theFork/midiSwitcher/hardware/mainbrd2/bom.txt

Atmega128RFA:

1x 0.25
Balun 100Ohm balanced, 50Ohm unbalanced
http://de.mouser.com/ProductDetail/Murata/LDB212G4010C-001/?qs=sGAEpiMZZMtMMXztyU6kdNOHRalcvD6j579H8Ei3rTA%3d

1x 1.26
Chipantenne
http://de.mouser.com/ProductDetail/Linx-Technologies/ANT-245-CHP-T/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
