theFork/midiSwitcher/hardware/mainbrd2/doc/spec.tex

\section{4x4 3.3V GPIO ports}
\section{$2.4~GHz$ wireless interface}
\section{$I^2C$ interface}
\section{Voltage supply}
$7~..~12~V$ input
$3.3~V$ internal voltage supply

\section{}
\section{}
\section{}
\section{}
