theFork/midiSwitcher/hardware/doku/portBelegung.pdf

Tabelle1

IC-PIN | Port / Bezeichnung | Nr. | Funktion
1
2 | PORT D (USART) | | RXD
3 | | | TXD
4 | Port D | 2 | FX-0
5 | | 3 | FX-1
6 | | 4 | FX-2
7
8
9
10
11 | Port D | 5 | FX-3
12 | | 6 | FX-4
13 | | 7 | FX-5
14 | Port B | 0 | FX-6
15 | | 1 | FX-7
16 | | 2 | LED A (Edit)
17 | | 3 | Taster B-1
18 | | 4 | Taster B-2
19 | | 5 | Taster B-3
20
21
22
23 | PORT C | 0 | Taster B-4
24 | | 1 | Taster A-1
25 | | 2 | Taster A-2
26 | | 3 | Taster A-3
27 | | 4 | Taster A-4
28 | | 5 | Taster A-5
