theFork/midiSwitcher/hardware/control_dog/maske.TIF

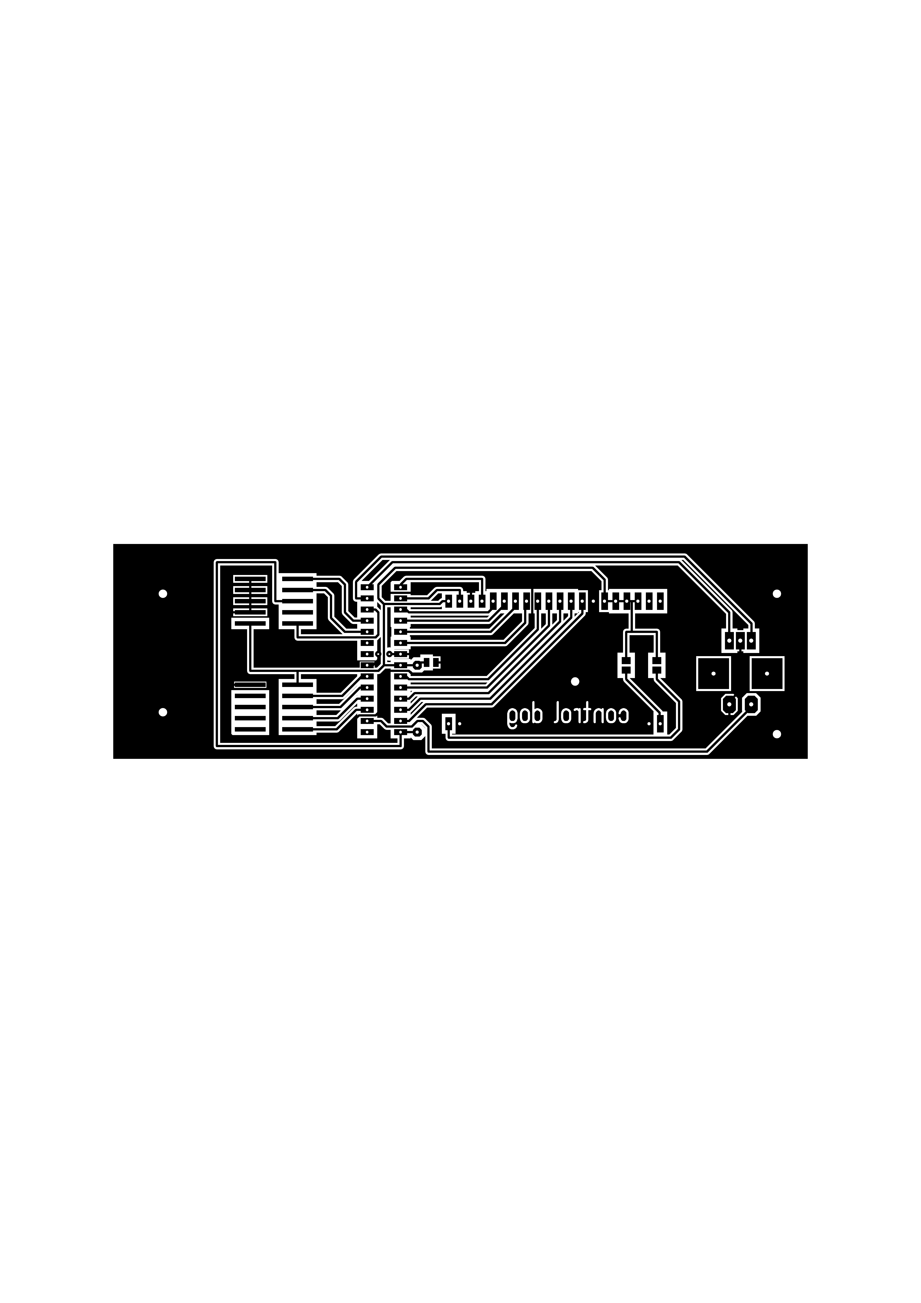
hardware/control_dog/maske.TIF
