theFork/midiSwitcher/hardware/control_dog/maske_2Fach.png

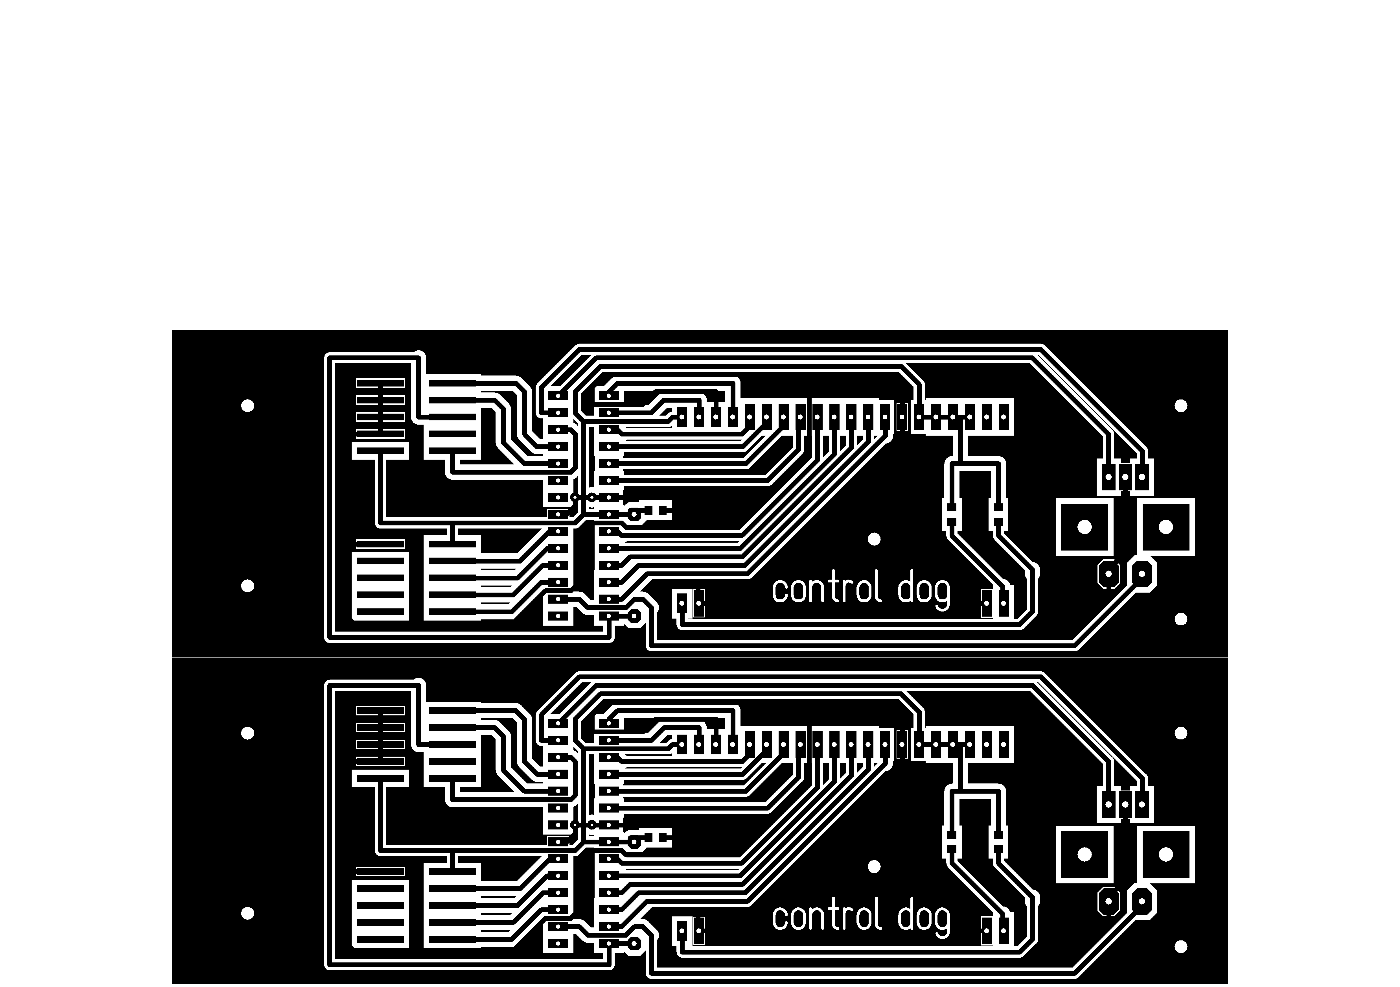
hardware/control_dog/maske_2Fach.png
