theFork/midiSwitcher/hardware/masken/ctrlDog.png

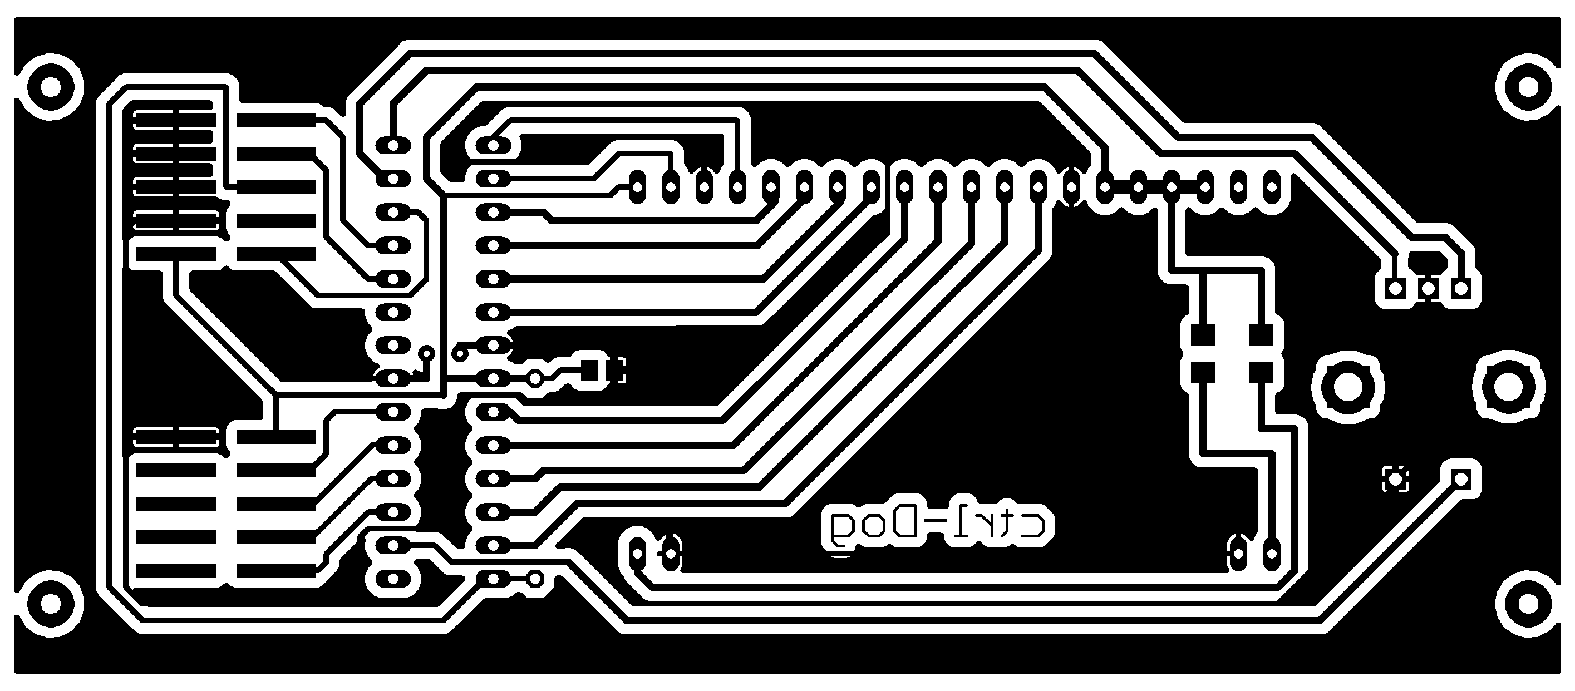
hardware/masken/ctrlDog.png
