theFork/midiSwitcher/hardware/masken/dualLoop.png

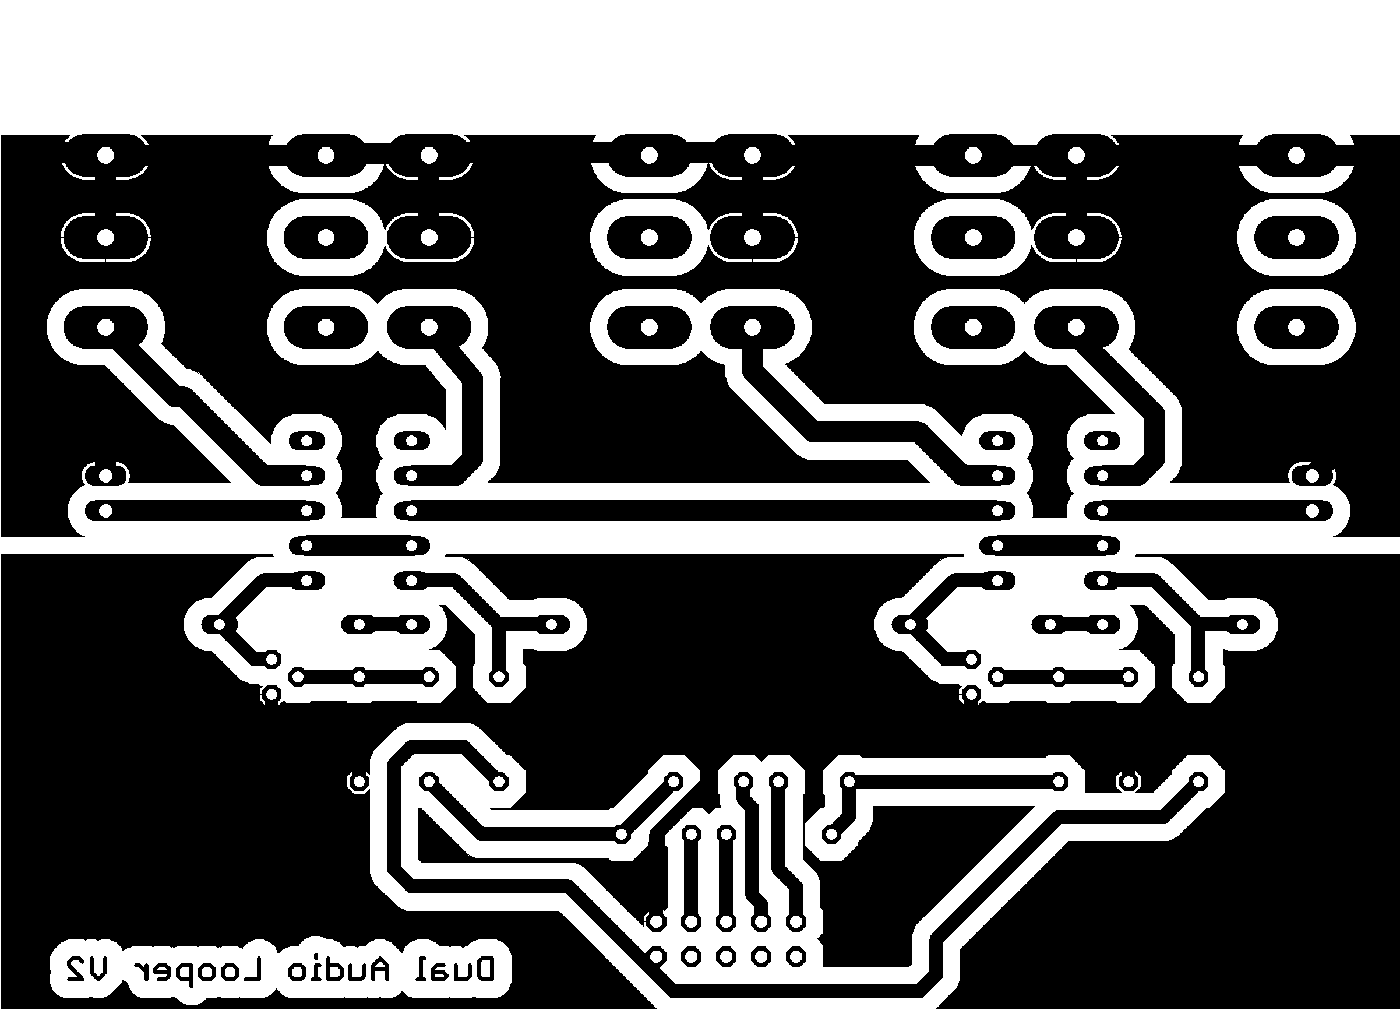
hardware/masken/dualLoop.png
