theFork/midiSwitcher/hardware/masken/dualSwitch.png

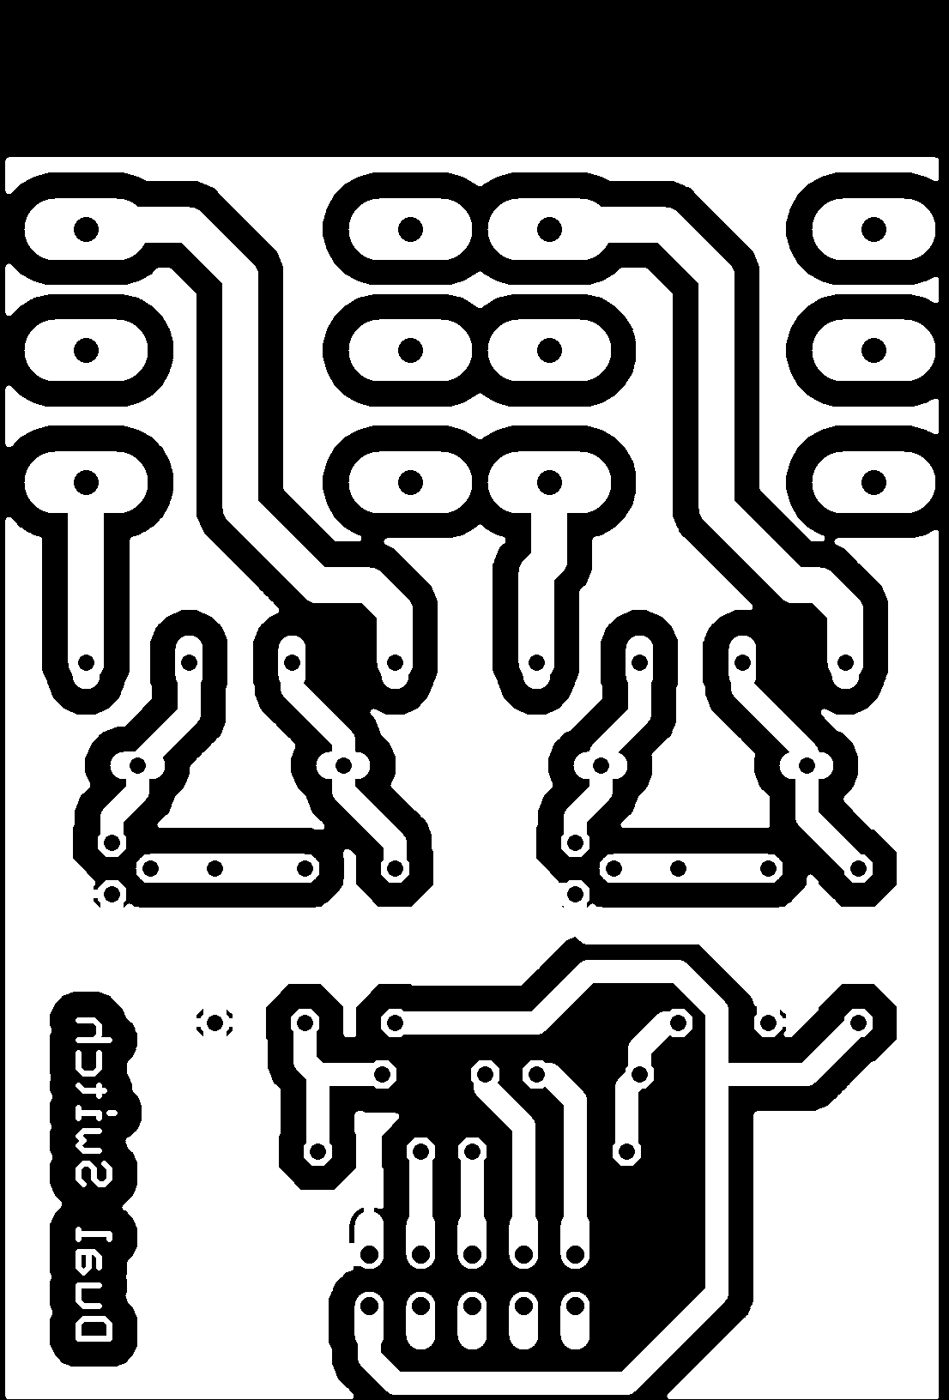
hardware/masken/dualSwitch.png
