theFork/midiSwitcher/hardware/masken/mainbrd.png

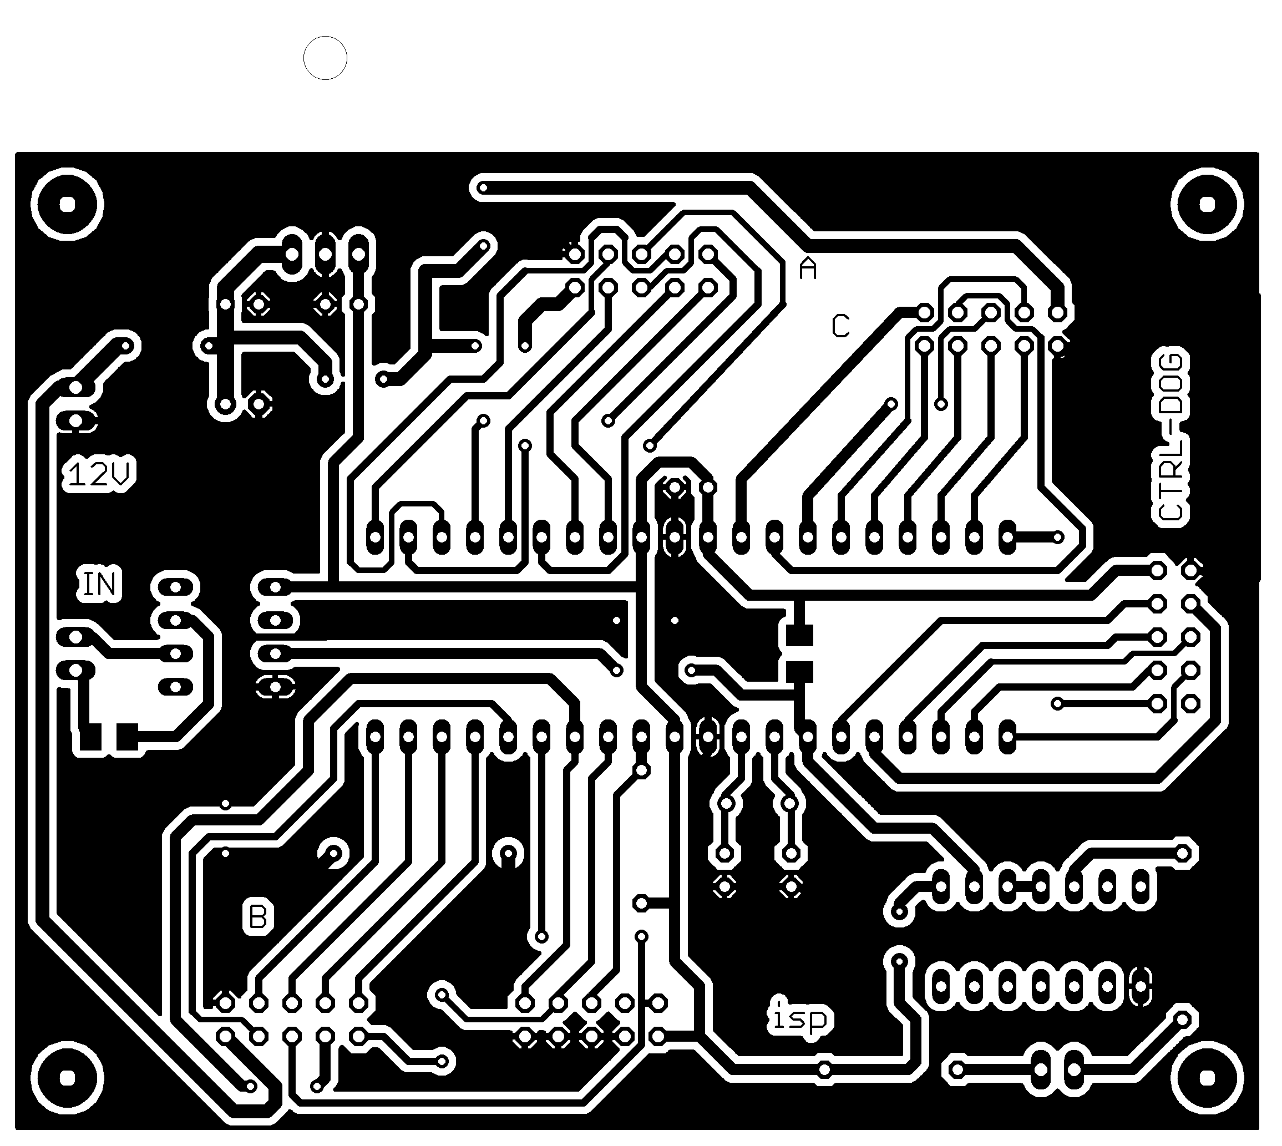
hardware/masken/mainbrd.png
