theFork/midiSwitcher/hardware/masken/netzteil.png

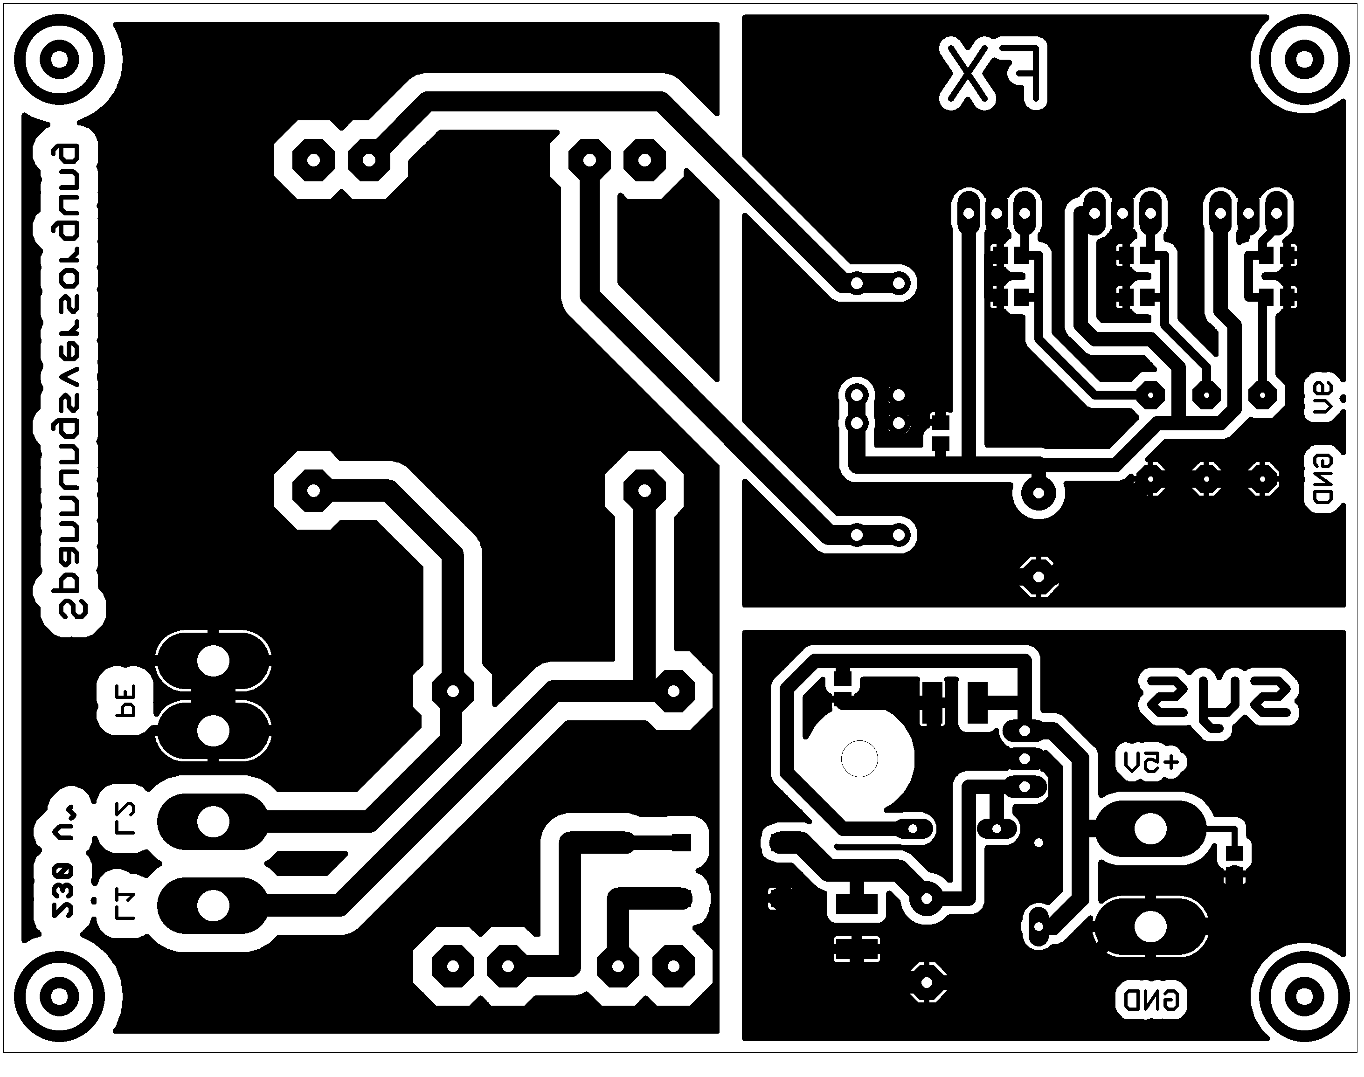
hardware/masken/netzteil.png
