theFork/midiSwitcher/hardware/masken/programmer3x.png

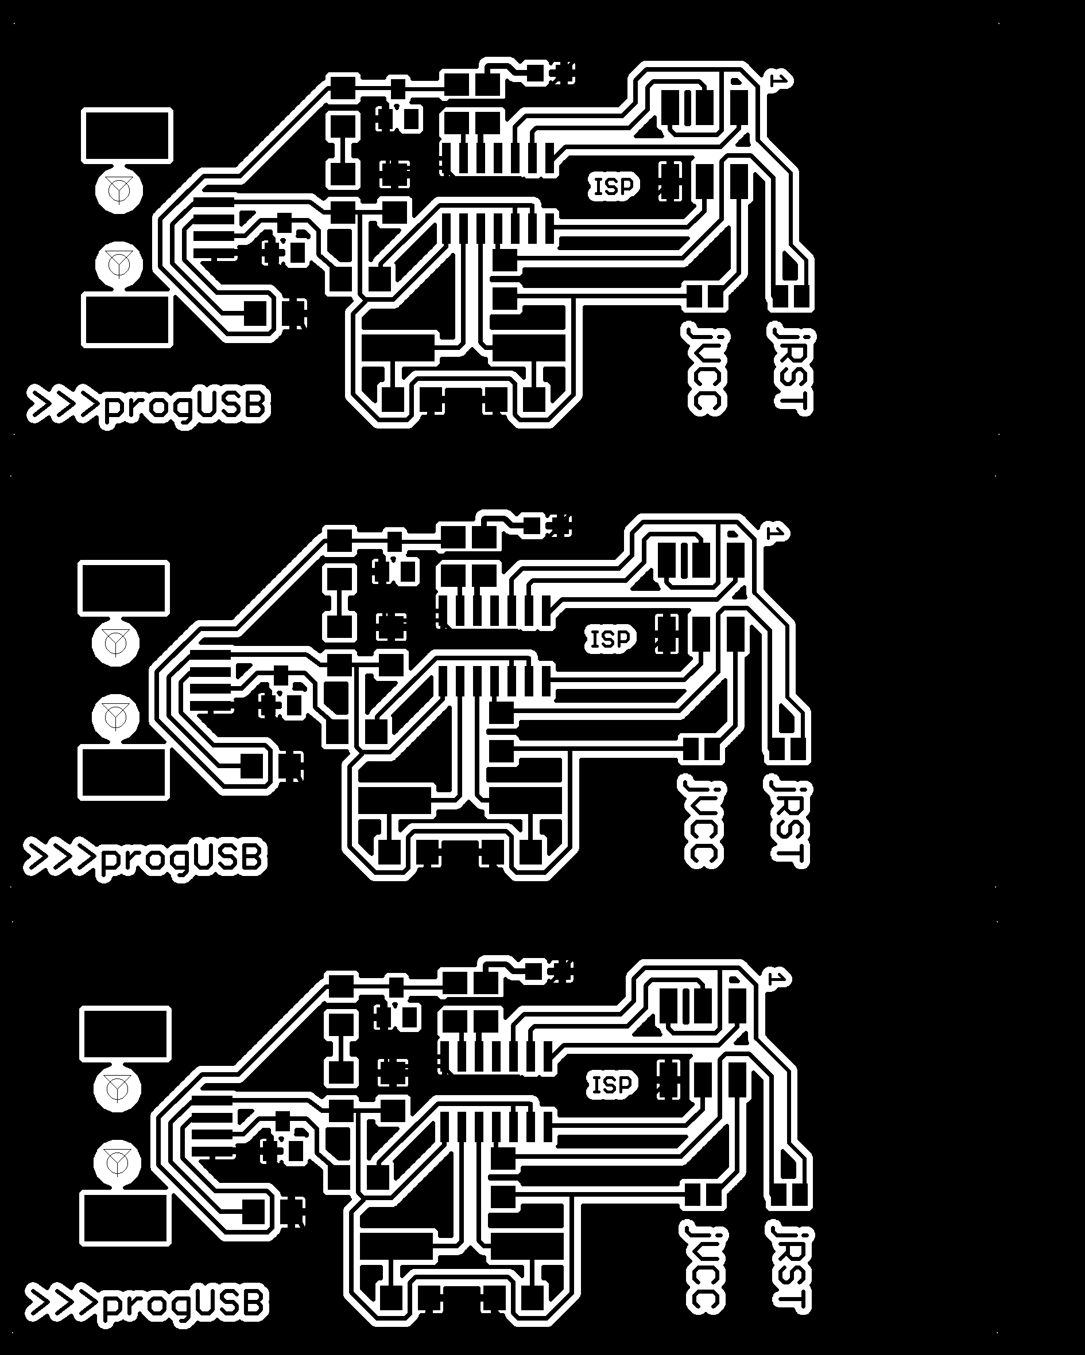
hardware/masken/programmer3x.png
