theFork/midiSwitcher/hardware/masken/programmer.png

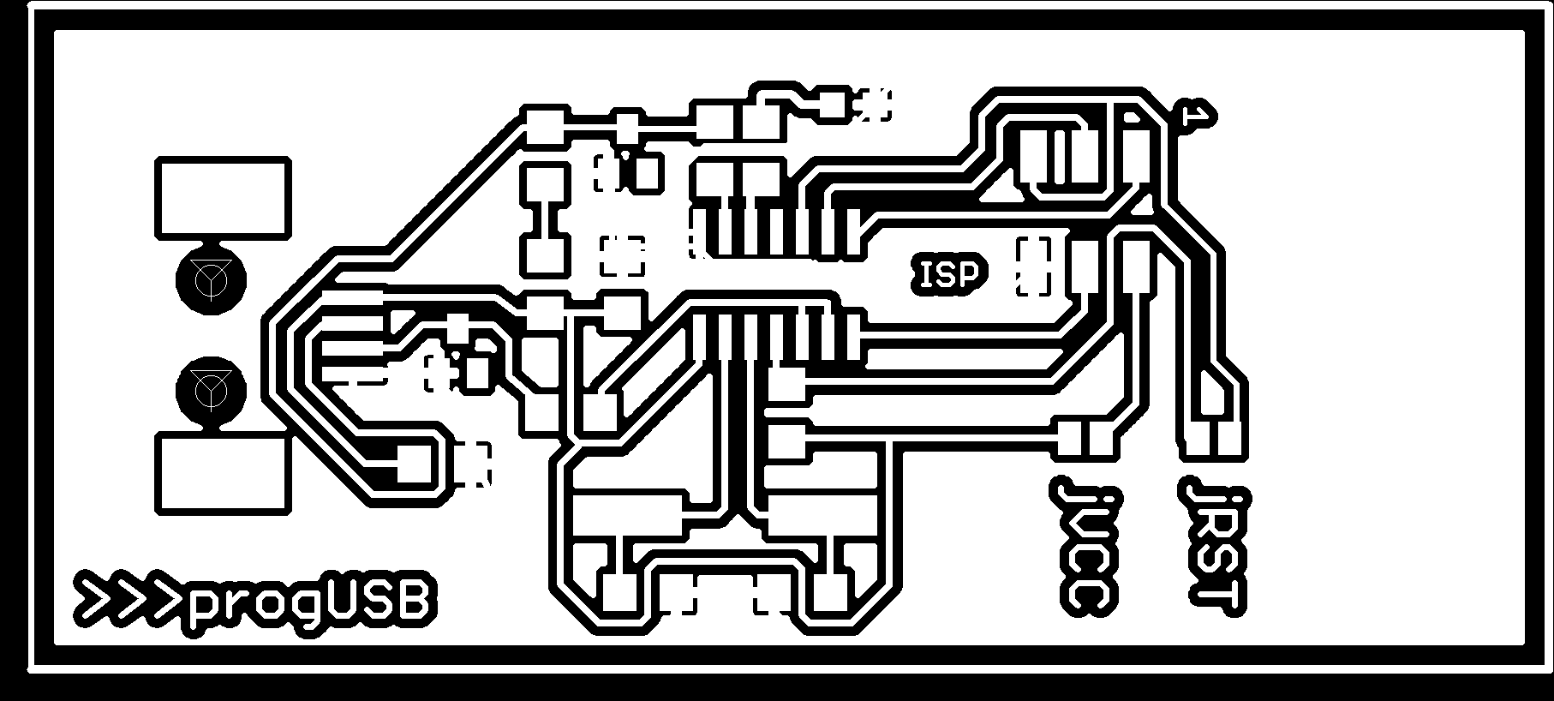
hardware/masken/programmer.png
