theFork/midiSwitcher/hardware/aktoren/DualLoopV2/bauteilliste.ods

Bauteilliste 4er Relaisplatine
Anzahl | Reichelt Art.Nr. | Stückpreis | Gesamt | Kommentar
4 | EBS 63P | 0,28 € | 1,12 € | Stereo-Klinkenbuchse mit Schalter
4 | G6H-2 6V | 2,70 € | 10,80 € | Relais
4 | 1N 4148 | 0,02 € | 0,08 € | Diode
4 | BC 547B | 0,04 € | 0,16 € | Transistor BC547B
8 | 1/4W 2,2K | 0,03 € | 0,26 € | Widerstand 2K2 10STK BESTELLEN!
4 | 1/4W 220 | 0,03 € | 0,13 € | Widerstand 220 10STK BESTELLEN!
 |  |  | 0,00 €
 |  |  | 0,00 €
 |  |  | 0,00 €
 |  | Summe: | 12,56 €
