theFork/midiSwitcher/hardware/bauteile.ods

Mainboard: |  |  |  | Modul "Dual Looper":
1x | BEL 75x100-1 | 0,96 € | 0,96 € | 1x | BEL 75X100-1 | 0,96 € | 0,96 €
3x | MKS-02 100N | 0,14 € | 0,42 € | 2x | T 9146 GN | 2,50 € | 5,00 €
1x | RAD 100/16 | 0,04 € | 0,04 € | 2x | 1/4W 1,0K | 0,10 € | 0,20 €
1x | ATMEGA 16-16 DIP | 3,65 € | 3,65 € | 2x | PFL 10 | 0,08 € | 0,16 €
1x | GS 40P | 0,55 € | 0,55 € | 4x | EBS 63P | 0,27 € | 1,08 €
5x | WSL 10G | 0,08 € | 0,40 € | 2x | G6H-2 6V | 2,95 € | 5,90 €
1x | 6N 138 | 0,58 € | 0,58 € | 2x | BC 547B | 0,04 € | 0,08 €
1x | µA 7805 | 0,28 € | 0,28 € | 2x | 1/4W 220 | 0,10 € | 0,20 €
1x | 74HC 14 | 0,22 € | 0,22 € | 4x | 1/4W 2,2K | 0,10 € | 0,40 €
1x | SMD 1/4W 220 | 0,10 € | 0,10 € | 1x | WSL 10G | 0,08 € | 0,08 €
1x | SMD 1/4W 1k | 0,10 € | 0,10 € | 2x | 1N 4148 | 0,02 € | 0,04 €
1x | 1/4W10k | 0,10 € | 0,10 € | 2x | ZF 30 | 0,04 € | 0,08 €
2x | 1/4W220 | 0,10 € | 0,20 € |  |  |  | 14,18 €
3x | PS 25/2G WS | 0,29 € | 0,87 €
4x | AHS 4,8 | 0,29 € | 1,16 € | Modul "Dual Switch":
2x | DIO-50S EMS | 1,85 € | 3,70 € | 1x | BEL 75X100-1 | 0,96 € | 0,96 €
1x | AWG 28-10F 3M | 2,90 € | 2,90 € | 2x | T 9146 GN | 2,50 € | 5,00 €
2x | PFL 10 | 0,08 € | 0,16 € | 2x | PFL 10 | 0,08 € | 0,16 €
2x | EBS 63P | 0,27 € | 0,54 € | 2x | EBS 63P | 0,27 € | 0,54 €
 |  |  | 16,23 € | 2x | SIL 7271-L 5V | 1,60 € | 3,20 €
 |  |  |  | 2x | BC 547B | 0,04 € | 0,08 €
 |  |  |  | 2x | 1/4W 470 | 0,10 € | 0,20 €
Spannungsversorgung: |  |  |  | 4x | 1/4W 2,2K | 0,10 € | 0,40 €
1x | BEL 160x100-1 | 1,70 € | 1,70 € | 1x | WSL 10G | 0,08 € | 0,08 €
1x | 421.15-1 | 3,20 € | 3,20 € | 2x | 1N 4148 | 0,02 € | 0,04 €
1x | EI 54/18,8 112 | 6,20 € | 6,20 € |  |  |  | 10,66 €
1x | SMD DF 02 | 0,21 € | 0,21 €
6x | 1N 4001 | 0,02 € | 0,12 € | Programmer
4x | X7R-G0805 100N | 0,05 € | 0,20 € | 1x | BEL 75x100-1 | 0,96 € | 0,96 €
2x | SMD-1812 330N | 0,52 € | 1,04 € | 2x | X7R-G1206 100N | 0,05 € | 0,10 €
2x | RAD FC 470/63 | 0,72 € | 1,44 € | 1x | X7R-G1206 10/25 | 0,24 € | 0,24 €
3x | µA 7809 | 0,32 € | 0,96 € | 2x | NPO-G1206 22P | 0,05 € | 0,10 €
1x | µA 7812 | 0,30 € | 0,30 € | 2x | SMD ZD 3,3 | 0,05 € | 0,10 €
5x | X7R-G0805 1,0/16 | 0,05 € | 0,25 € | 1x | ATTINY 44-20 SSU | 2,35 € | 2,35 €
1x | KES 3SI | 1,25 € | 1,25 € | 1x | SMD-LED 0805 GN | 0,09 € | 0,09 €
1x | FLINK 1,8A | 0,29 € | 0,29 € | 1x | 12,0000-HC49-SMD | 0,24 € | 0,24 €
5x | AHS 9,5 | 0,42 € | 2,10 € | 2x | SMD 1/4W 51 | 0,10 € | 0,20 €
 |  |  | 17,16 € | 2x | SMD 1/4W 510 | 0,10 € | 0,20 €
 |  |  |  | 1x | SMD 1/4W 1,0K | 0,10 € | 0,10 €
 |  |  |  | 1x | SMD 1/4W 10K | 0,10 € | 0,10 €
CTRL-DOG: |  |  |  | 1x | USB BW SMD | 0,62 € | 0,62 €
1x | BEL 75x100-1 | 0,96 € | 0,96 € | 1x | SL 2X10G SMD2,54 | 0,48 € | 0,48 €
1x | EADOGM162E-A | 11,85 € | 11,85 € |  |  |  | 5,88 €
1x | EA LED55X31-G | 3,15 € | 3,15 €
1x | KNOPF 13-164E | 0,39 € | 0,39 €
1x | STEC12E08 | 1,90 € | 1,90 €
1x | ATMEGA 8-16 DIP | 2,60 € | 2,60 €
1x | SL 2X10G SMD2,54 | 0,48 € | 0,48 €
1x | X7R-G0805 100N | 0,05 € | 0,05 €
1x | SMD 1/4W 10K | 0,10 € | 0,10 €
2x | SMD 1/4W 56 | 0,10 € | 0,20 €
4x | AHS 15,9 | 0,42 € | 1,68 €
 |  |  | 23,36 €
 |  |  |  | Beispiel (haggl):
 |  |  |  | 1x | Rackgehäuse | 45,00 € | 45,00 €
 |  |  |  | 1x | Stromversorgung | 17,16 € | 17,16 €
 |  |  |  | 1x | Mainboard | 16,23 € | 16,23 €
 |  |  |  | 2x | +-- DL | 14,18 € | 28,36 €
 |  |  |  | 2x | +-- DL | 14,18 € | 28,36 €
 |  |  |  | 2x | +-- DS | 10,66 € | 21,32 €
 |  |  |  | 1x | CTRL-DOG | 23,36 € | 23,36 €
 |  |  |  | 2x | Programmer | 5,88 € | 11,76 €
 |  |  |  |  |  |  | 179,79 €
