theFork/midiSwitcher/hardware/doku/rueckplatteV1.dxf

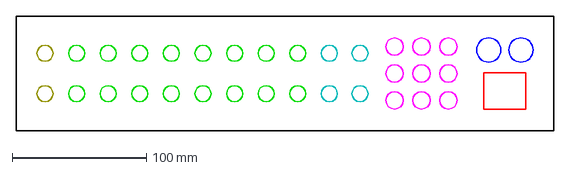
[picture p10: CAD file, 2013-02-09]
hardware/doku/rueckplatteV1.dxf
400.0 x 85.0 mm
