theFork/midiSwitcher/hardware/doku/frontplatteV1.dxf

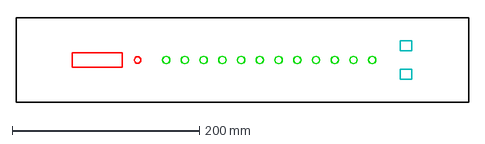
[picture p11: CAD file, 2013-02-09]
hardware/doku/frontplatteV1.dxf
483.0 x 90.0 mm
