theFork/midiSwitcher/hardware/aktoren/Quadmachine/specs/amphenol jack.pdf

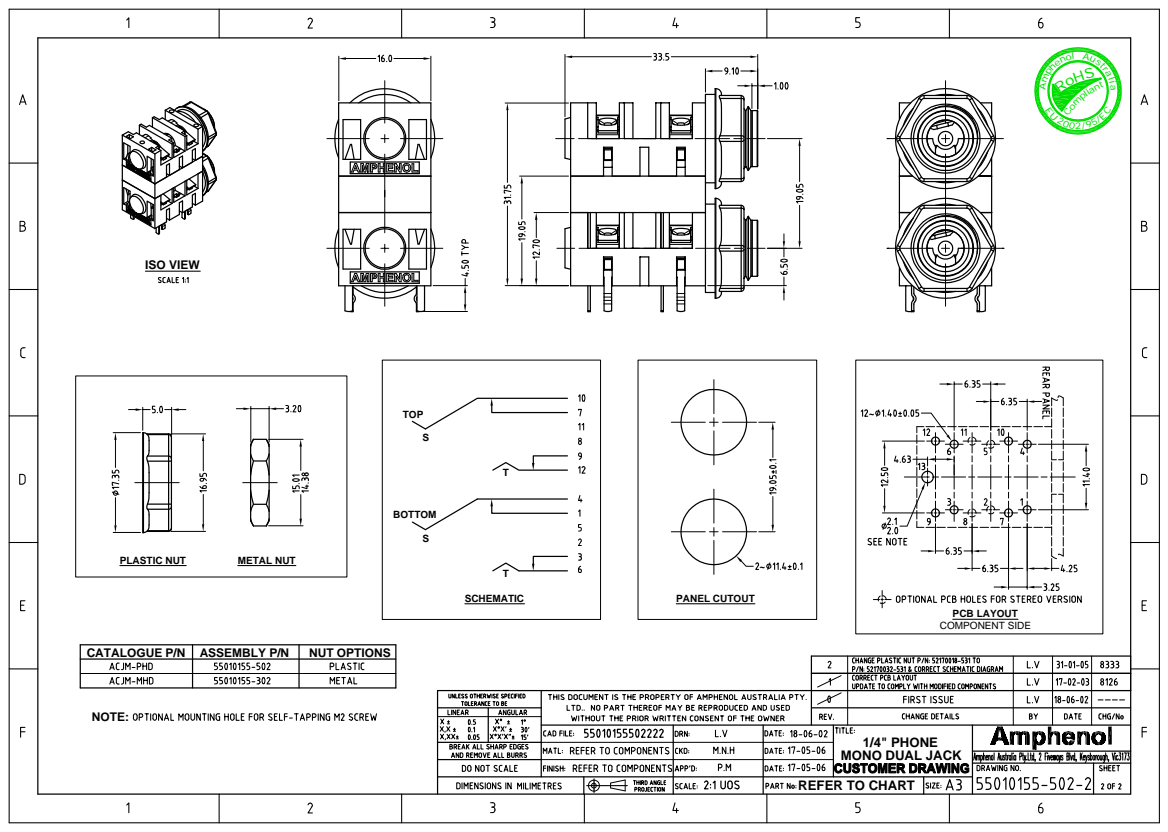
[picture p12: page 1]
ISO VIEW; PLASTIC NUT; METAL NUT; ial p m nt; l Au rts; SCHEMATIC; BOTTOM; TOP; PCB LAYOUT COMPONENT SIDE; PANEL CUTOUT; ASSEMBLY P/N; NOTE:; CATALOGUE P/N; NUT OPTIONS

1/4" PHONE MONO DUAL JACK

REFER TO CHART
