theFork/midiSwitcher/hardware/control_dog/ctrl_dog.pdf

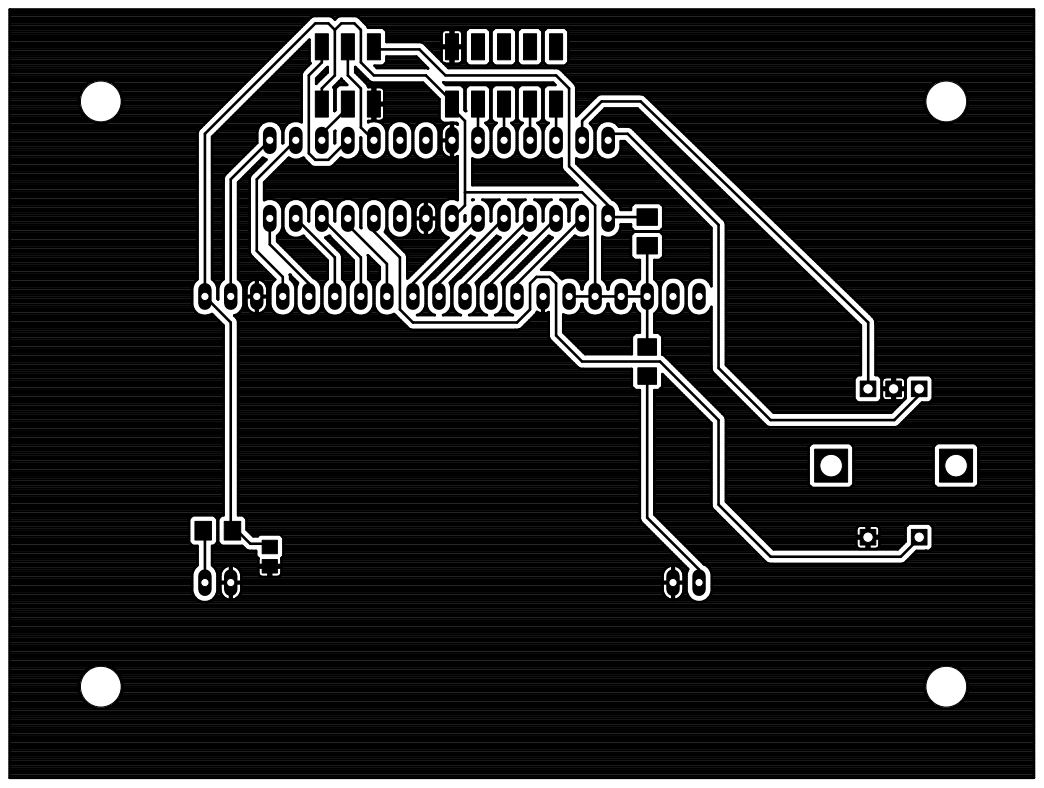
[picture p13: page 1]
