theFork/midiSwitcher/hardware/doku/mainbrdV2.pdf

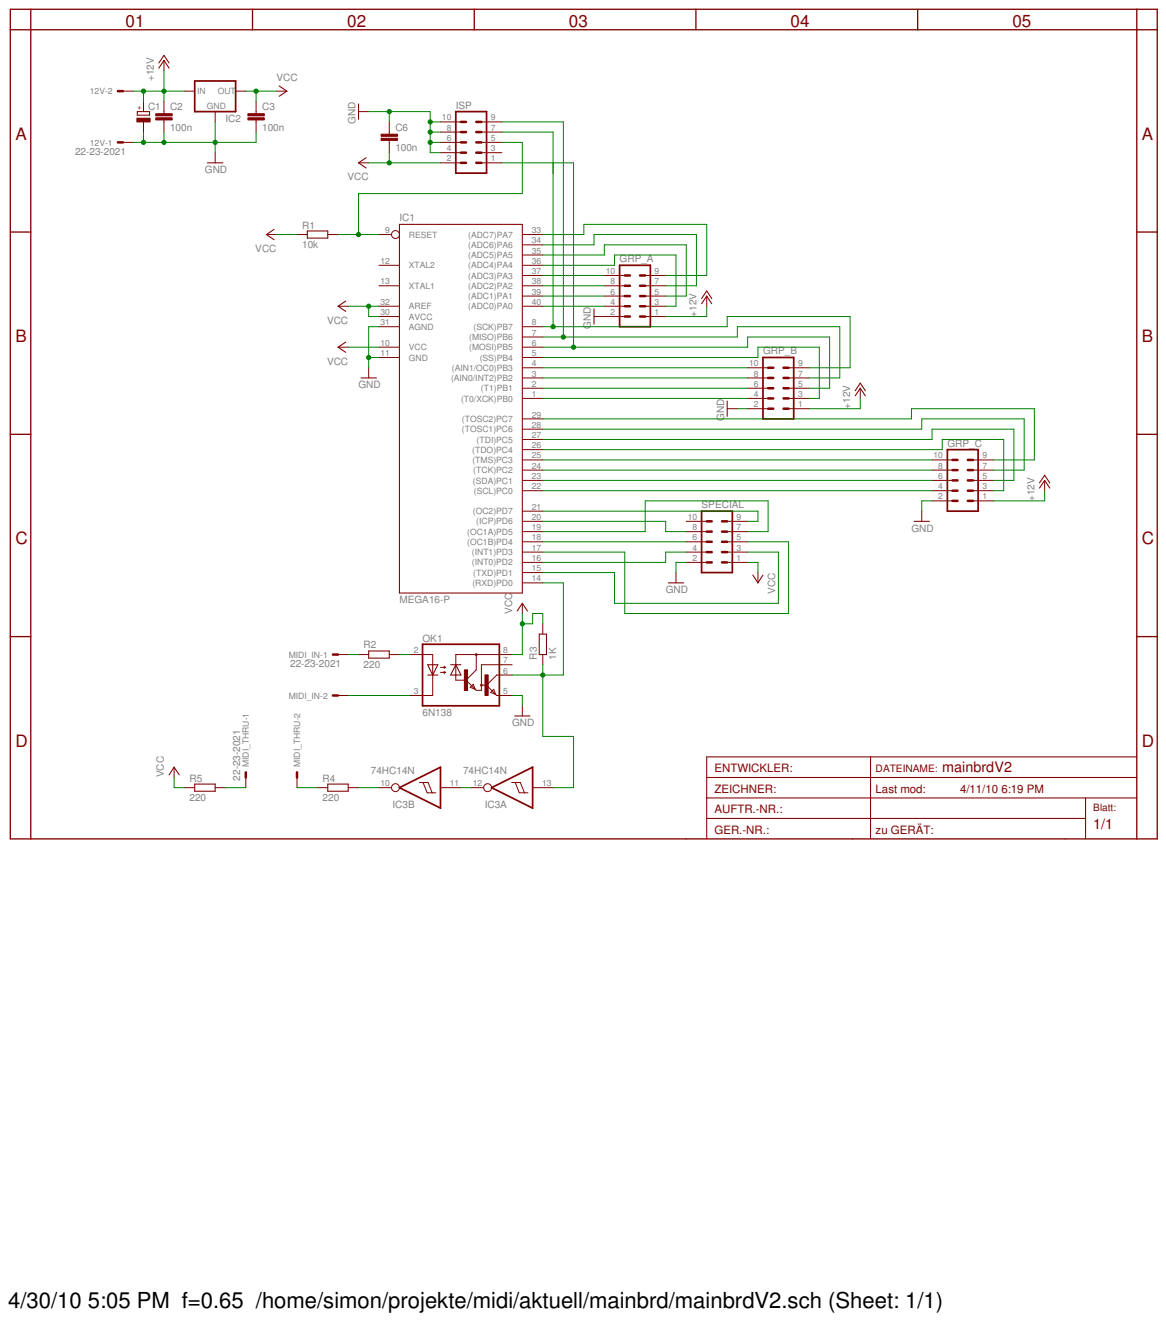
[picture p14: page 1]

35
36
37
38 | 8 | | 7
39 | 6
40 | 4 | | 3

1 4 | | 3
29 | 2 | | 1

DATEINAME: mainbrdV2
Last mod: 4/11/10 6:19 PM

4/30/10 5:05 PM f=0.65 /home/simon/projekte/midi/aktuell/mainbrd/mainbrdV2.sch (Sheet: 1/1)
