theFork/midiSwitcher/hardware/doku/USB-B-SMD.pdf

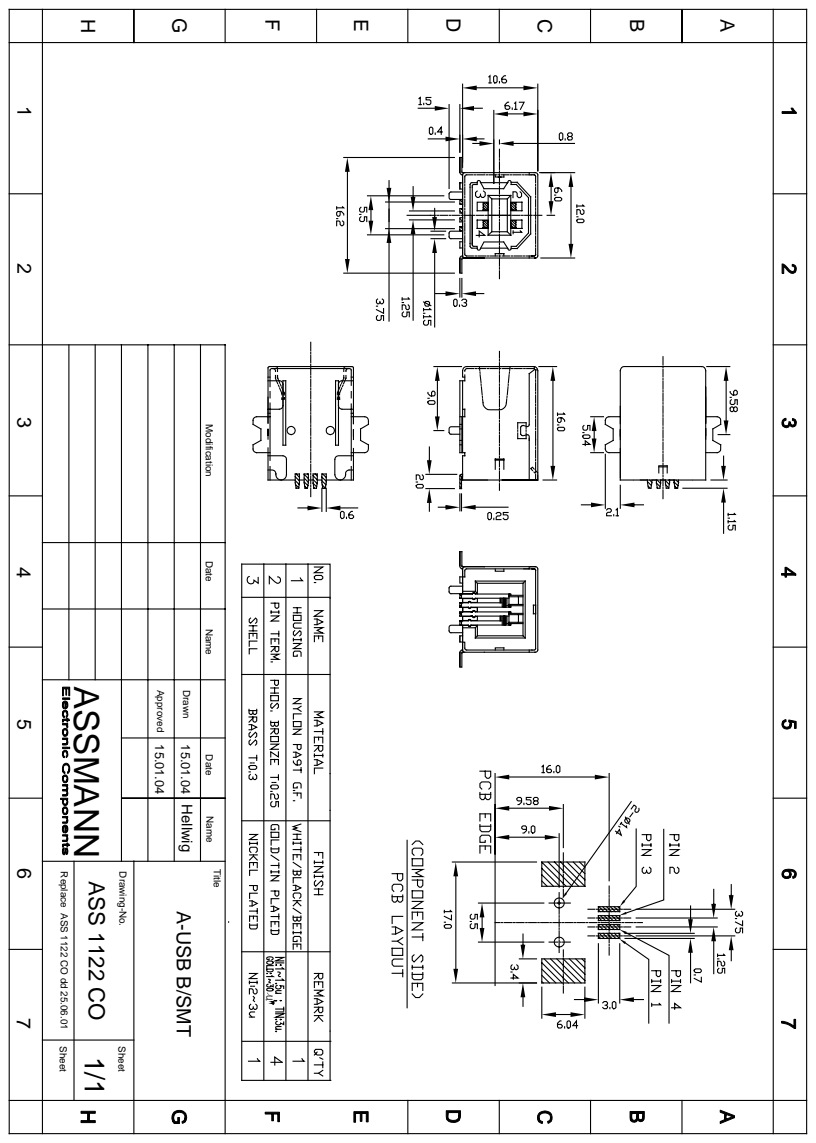
[picture p15: page 1]
ASS 1122 CO; Date Name

Modification Name Date

15.01.04 Hellwig A-USB B/SMT

Replace ASS 1122 CO dd 25.06.01
