theFork/midiSwitcher/(commit log)

2013-02-09 export to github
    [5V+9V.brd, 5V+9V.sch, 5V.brd, 5V.sch, bauteile.ods, bauteilliste.ods, ctrl_dog.brd, ctrl_dog.sch]
2013-04-10 added amphenol 3.6mm jack stack spec
2013-04-17 added mainbrd2: 3.3V version with I2C portexpander, jtag, zigBee
2013-04-19 made tiny Midi-Mainboard SPII2C-Busrouter. 75x50mm, Midi, Zigbee, SPI, I2C. 3V3
2013-04-19 added 50x50mm Version, requires additional 10..15 Eur for PCB
2013-04-22 routed Quadmachine I2C
2013-04-22 manual optimization Quadmachine I2C
2013-04-22 further manual optimization Quadmachine I2C
2013-04-22 finished Quadmachine I2C
2013-04-22 etched Quadmachine I2C
2013-04-26 routed mainboard2. therefore removed leds and assigned 1206 package to some parts
2013-05-08 changing thinnest wire to 250um
2013-05-08 changing all drill holes to .6mm to increase drilling accuracy
2013-05-29 Add 10-Pin GPIO connector to PF0..PF7, 3.3V and DGND
2013-05-29 Add documentation to the pcb
2014-02-13 Turn impulse1 into a third switch
2014-02-13 Implement momentary switch with NOTE ON / NOTE OFF
2014-02-16 mainbrd: Disable interrupts during MIDI ISR
2014-03-01 ctrldog: Fix EEMEM mapping
    [interface.c]
